pokliu/battery_frame/README.md

# 32140 16S2P 电动自行车电池支架（PETG 3D 打印）

为 32 只小鲁 32140 电芯（16S2P）设计的电池支架（v3）。它装进外框 275（高）×220×165、板厚 0.85 的手工焊接不锈钢箱（内腔约 273.3×218.3×163.3），桶内贴青稞纸。只有底部垫 3 mm 硅胶条；两侧只贴青稞纸，轴向留 5 mm 装配余量（卖家要求，含纸）；顶部不放硅胶，压框顶面到箱盖留 15（让开箱盖紧固螺丝），每条边正中间一个凸台顶住箱盖；前后每边留 1.5。配套 BMS 是 JK-BD6AxxS-8PD。模型由参数化的 FreeCAD 脚本生成，改参数后重跑即可。

## 目录

| 路径 | 内容 |
|---|---|
| `battery_holder_v3.py` | 参数化建模脚本，参数表 `P` 在文件顶部 |
| `电池支架_v3.FCStd` | 生成的模型（打印零件、参考假体、试打块） |
| `STL/`、`STEP/` | 打印文件（按打印方向摆好）和装配坐标 STEP |
| `电池支架v3-需求与进展.md` | 详细参数、连接表、出线、校验、装配顺序、外购件、待实测 |
| `plan_v3.md` | 设计计划 |
| `打印参数_A1_PETG.md` | 各打印件的 Bambu Studio 切片参数 |
| `fem_v3.py`、`fem_run_v3.py` | 受力分析脚本（FreeCAD FEM + CalculiX） |
| `FEA/受力分析报告_v3.md`、`FEA/v3_results.json` | 受力分析结果 |
| `AGENTS.md` | AI 助手设计/修改模型的流程和规则 |
| `JK-BD6A24S06PD.pdf` | BMS 规格书 |

## 设计概要

- **排布**：35 mm 节距正方形网格，下面 5 层每层 6 只，顶层 2 只靠右，顶层空出的位置放 BMS。
- **结构**：两端各一片 24 深的电芯座（挡边 1.5，Ø24 点焊孔），中间 95.5 mm 敞开散热。端盖 A 6.1 厚、B 8.7 厚，底板整面，隔着青稞纸顶住箱壁；支撑垫放在电芯之间的星形位上。6 颗 M4×150 内六角螺丝贯穿端盖 A、两片座（Ø14 定位管定距）和端盖 B，螺丝头没入端盖 A 沉孔，另一端拧进端盖 B 的 M4×8×6 热熔螺母。
- **连接片**：0.1 铜 + 0.1 镍，宽 20。6 处用 4 只一排的直条，9 处用 2×2 整块方片。B−、B+ 都在 B 端最上面一层。
- **出线**：端子片从正中间向上延伸成引出片，伸出支架顶面 22 mm，12AWG 在顶面以上锡焊，从压框顶部开口引到箱盖。
- **缓冲**：只有底部两条 3 mm 硅胶条。
- **温度探头**：贴在中心电芯中段，线从 A 座的 Ø6 孔出来。

## 零件与打印

| 零件 | 数量 | 打印尺寸 (mm) | 打印方向 |
|---|---|---|---|
| 电芯座A | 1 | 214.7×218×73.8 | 挡边朝下，无支撑 |
| 电芯座B | 1 | 214.7×218×71.8 | 挡边朝下，无支撑 |
| 端盖A（螺丝头沉孔） | 1 | 214.7×218×6.1 | 底板朝下 |
| 端盖B（热熔螺母） | 1 | 214.7×218×8.7 | 底板朝下，打完从外表面压入 6 颗 M4×8×6 热熔螺母 |
| 顶部压框 | 1 | 214.7×158.3×72 | 顶环朝下 |
| 压框顶凸台 | 4（一个 STL） | 214.7×158.3×17.5（4 件分开摆） | 顶面朝下，销朝上 |
| 试打块 | 1 | 113×90×27 | 挡边面朝下，**先打这个** |

- 实体合计 1147 cm³。
- 切片参数（拓竹 A1 + PETG + Bambu Studio）见 `打印参数_A1_PETG.md`：层高 0.2、首层 0.3，每个零件的墙层数、底壳层数、填充、Brim 分别给出。
- 当前尺寸按青壳纸 0.3、内腔 = 外框 − 2×0.85 推算，实测后改 `liner_t` / `box_inner` 重跑再打印。

## 外购件

| 物料 | 规格 | 数量 |
|---|---|---|
| 电芯 | 小鲁 32140，Ø33.2±0.2 × 140±0.3 | 32 |
| M4 内六角螺丝 | DIN912 不锈钢 M4×150（头 Ø6.8×4） | 6 |
| M4 热熔螺母 | M4×8×6（长 8、外径 6），端盖 B | 6 |
| M4 普通螺母 + 垫片 | 点焊时临时夹紧用 | 各 6 |
| M3 热熔螺母 + 螺丝 | 孔 Ø4.0 × 6 | 各 4 |
| 硅胶条 | 3×40 长约 215（只放底部） | 2 |
| 铜片、镍条 | 0.1 厚，宽 20；方片约 55×55；引出片 20 宽 | 按需 |
| 12AWG 硅胶线 | 外径 4.5 | 按需 |
| BMS | JK-BD6AxxS-8PD | 1 |
| 青壳纸、青稞纸、Kapton、中性硅胶 | — | 按需 |

## 重新生成模型

在 FreeCAD 1.1 的 Python 控制台执行：

```python
exec(open('/Users/admin/Downloads/battery/battery_holder_v3.py', encoding='utf-8').read())
R = build_all()   # 重建文档「电池支架_v3」，返回校验报告
export_all()      # 导出 STL/、STEP/ 并保存 电池支架_v3.FCStd
```

常改的参数：

| 参数 | 默认值 | 说明 |
|---|---|---|
| `hole_d` | 33.6 | 电芯孔径，按试打块结果改 |
| `lip_t` | 1.5 | 挡边厚（FEA 定） |
| `liner_t` | 0.3 | 青壳纸厚，量到实际值后改 |
| `box_outer` / `sheet_t` / `box_inner` | 220×275×165 / 0.85 / None | 箱外框、板厚；有实测内腔时填 `box_inner` |
| `gap_x` | 1.5 | 前后每边空隙（影响外壁厚） |
| `z_clear_total` | 5.0 | 轴向装配余量合计（含两侧青稞纸） |
| `end_rubber_t` / `top_rubber_t` / `fit_clear` | 0 / 0 / 15 | 两侧、顶部硅胶垫厚（0 = 不放）；压框顶面到箱盖空隙 |
| `insert_hole_d` | 5.6 | 端盖 B 热熔螺母孔，按试打块改 |
| `main_wire_x` / `bplus_x` | None | 引出片 X，None = 端子片正中间 |
| `strip_w` | 20 | 连接片宽 |
| `series` | 16 组 | 串联顺序，两个端子都在最上面一层 |
| `rods` / `bolt_len` | 6 个星形位 / 150 | 螺栓位置、螺丝杆长（沉孔深度自动算） |

受力分析（无界面，较慢）：`freecadcmd fem_run_v3.py`，结果写入 `FEA/v3_results.json`。

## 当前状态

- [x] 建模、自动校验、导出 STL/STEP
- [x] 受力分析（侧摔 50 g、前后/竖直 5 g、50 °C）
- [ ] 实测钢箱内腔和青壳纸厚度，更新参数后重跑
- [ ] 打印试打块；先打一块端盖进箱试配
- [ ] 量铜镍片宽度；确认箱盖插座位置、BMS 端子位置
