pokliu/battery_frame/打印参数_A1_PETG.md

# 打印参数（拓竹 A1 + PETG + Bambu Studio）

适用：0.4 喷嘴，PETG（拓竹 PETG HF / PETG Basic 或同类），纹理 PEI 板。STL 已按打印方向摆好（`STL/` 里每个文件落在 Z=0），导入后直接居中，不要旋转。
基础预设选「0.20mm Standard @BBL A1」+ 对应的 PETG 耗材预设，再按下面改。界面名称以 Bambu Studio 中文界面为准。

## 1. 通用设置（所有零件）

| 位置 | 参数 | 值 | 原因 |
|---|---|---|---|
| 打印板 | 板型 | 纹理 PEI 板 | PETG 在光面 PEI 上粘得太牢，会撕掉板面；用光面板必须涂胶 |
| 耗材 | 喷嘴温度 | 首层 250，其余 245 | 拓竹标的 PETG HF 范围是 230~260 ℃（[拓竹 PETG HF 页面](https://bambulab.com/en-eu/filament/petg-hf)）；偏高一点层间结合更好 |
| 耗材 | 热床温度（纹理 PEI） | 70 | 拓竹 TDS 范围 65~75 ℃（[PETG HF TDS](https://filaments.lv/wp-content/uploads/2026/05/Bambulab-PETG-HF-Filament-TDS.pdf)） |
| 耗材 | 冷却风扇 | 用耗材预设默认（PETG 一般 ≤ 60%） | 风太大层间结合变差 |
| 质量 | 层高 | **0.20** | |
| 质量 | 首层层高 | **0.30** | 见下面"层高说明"：首层 0.3 + 0.2×n 正好卡住挡边 1.5、底板 2.5、端盖 6.1 / 8.7、凸台 14.5 |
| 质量 | 线宽 | 默认 0.42 | |
| 质量 | 墙生成器 | Arachne（默认） | 电芯孔间壁只有 1.4，Arachne 能用变线宽填满 |
| 质量 | X-Y 孔洞补偿 / X-Y 轮廓补偿 | **0 / 0** | 孔径以试打块实测为准，**改脚本参数**（`hole_d`、`insert_hole_d` 等），不在切片里补偿，否则模型和实物对不上 |
| 质量 | 象脚补偿 | 默认 0.15 | |
| 强度 | 稀疏填充图案 | 螺旋体（gyroid） | 各方向强度接近 |
| 支撑 | 开启支撑 | **关** | 所有零件都按免支撑设计（悬垂 ≤45°、菱形窗、水滴孔） |
| 其他 | 打印顺序 | 逐层 | 每盘只放一个大件 |

打印前把 PETG 烘干（65 ℃ 约 6~8 小时）。受潮的 PETG 拉丝多、表面起泡，层间结合也会变差。

### 层高说明
Bambu Studio 按层切片，零件上不是层高整数倍的台阶会被就近取整，误差最多半层。本项目的关键高度是：

| 高度 | 首层 0.2 + 0.2×n | 首层 0.3 + 0.2×n |
|---|---|---|
| 挡边 1.5 | 1.4 或 1.6 ✗ | 0.3 + 6×0.2 = 1.5 ✓ |
| 端盖底板 2.5 | ✗ | 0.3 + 11×0.2 = 2.5 ✓ |
| 端盖 A 6.1 / 端盖 B 8.7 | ✗ | ✓ / ✓ |
| 凸台 14.5 | ✗ | ✓ |

所以统一用首层 0.30。0.4 喷嘴的首层 0.3 在允许范围内，大平面也更容易粘牢。

## 2. 各零件参数

| 零件（STL） | 数量 | 摆放 | 墙层数 | 顶 / 底壳层数 | 填充 | 外墙速度 | Brim | 实体体积（上限） |
|---|---|---|---|---|---|---|---|---|
| 试打块 | 1 | 挡边面朝下（STL 已摆好） | 4 | 5 / 8 | 30% | 100 | 无 | — |
| 电芯座A | 1 | 挡边朝下，定位管朝上 | 4 | 5 / **8** | 30% | **100** | 无 | 370 cm³（≤470 g） |
| 电芯座B | 1 | 同上 | 4 | 5 / **8** | 30% | **100** | 无 | 368 cm³（≤468 g） |
| 端盖A | 1 | 底板朝下 | 4 | 5 / **12** | 40% | 150 | 无 | 123 cm³（≤156 g） |
| 端盖B | 1 | 底板朝下 | **5** | 5 / **12** | 40% | 150 | 无 | 137 cm³（≤174 g） |
| 顶部压框 | 1 | 顶环朝下 | 4 | 5 / **20** | 30% | **100** | **外侧 5 mm** | 133 cm³（≤169 g） |
| 压框顶凸台x4 | 1 盘 4 件 | 顶面朝下，销朝上 | 4 | 5 / 5 | 50% | 100 | 无 | 15 cm³ |

体积是 `checks()` 算的实心体积，克数按 PETG 1.27 g/cm³ 算，是上限，实际用量看 Bambu Studio 切片结果。整套上限约 1.45 kg，加上试打块和试错，准备 2 kg。

### 电芯座 A / B
- **底壳 8 层**：首层 0.3 + 7×0.2 = 1.7 ≥ 挡边 1.5，挡边整片是实心的。挡边是侧摔时直接挡电芯的面，不能有填充。
- **墙 4 层**：孔间壁 1.4、外壁 3.05 这些地方基本全是墙，30% 填充只落在星形位和角上。
- **外墙速度 100**：电芯孔的圆度直接影响装配。A1 是床动机型，零件约 0.45 kg 跟着热床前后移动；上部 6 根 Ø14 定位管单独伸出约 48 mm，慢一点更稳。
- 上部只剩 6 根定位管时每层很小，保持耗材预设里的"层时间不足时降速"（默认开），不然 PETG 会软塌。
- 管顶的凸止口（A）、凹止口（B）配合间隙只有单边 0.2，打完先试插再装电芯。

### 端盖 A / B
- **底壳 12 层**：0.3 + 11×0.2 = 2.5，正好是底板厚，整块底板实心。它是连接片和钢箱壁之间唯一的塑料层，也是侧摔时的承压面。
- 支撑垫 Ø12/Ø13、外周凸台宽 5，4 层墙已经基本把它们填满。
- **端盖 B 墙 5 层**：热熔螺母孔 Ø5.6 周围要实心塑料，5 层墙（约 2.1 mm）加上 Ø13 垫，孔周基本全是墙。
- 端盖只有 6~9 mm 高、面积大，外墙 150 就行。
- 外周凸台侧面的菱形通风窗（A 高 2.4、B 高 5）是 45° 自支撑的，不加支撑。A 的窗很小，上下尖角会被线宽填掉一点，属于正常。
- **热熔螺母（端盖 B）**：打完后从端盖 B **外表面**（贴打印板的那面）压入 6 颗 M4×8×6。烙铁 230~245 ℃，垂直慢压，压到比表面低约 0.3 停，趁热用平面压一下保证不歪。

### 顶部压框
- 顶环朝下，墙只有 3 厚、高 72，底面只有一圈 10 宽的顶环贴板，**加 5 mm 外侧 Brim**，防止床动时翘边或被撞倒。
- **底壳 20 层**：0.3 + 19×0.2 = 4.1 ≥ 顶环厚 4，顶环整圈实心。凸台的压力经顶环传到墙上。
- 外墙 100：薄墙高件，床动机型上不要快。
- 侧墙上的菱形窗是 45° 自支撑的，不加支撑。
- 顶环和两条对角支撑条都贴在打印板上，是第一层的一部分。

### 压框顶凸台
- 一盘打 4 个（20 宽的两个放长边，30 宽的两个放短边）。凸台顶面贴板，Ø4 定位销朝上，销是最后几层。
- 小件，填充 50% 即可，只受压。

### 试打块（最先打）
- 和电芯座同样设置，结果才有参考价值。
- 量完后改脚本：`hole_d`（电芯孔）、`lip_t`（挡边）、`socket_d` / `spigot_d`（止口）、`insert_hole_d`（M4 热熔孔，三个孔 Ø5.5/5.6/5.7，有缺口标记的是 5.5）、`m3_d`。改完重跑 `build_all()` → `export_all()` 再打正式件。

## 3. 建议打印顺序
1. 试打块 → 实测，改参数，重新导出。
2. 端盖 A（最薄最快）→ 放进钢箱试配两侧和前后空隙。
3. 电芯座 A、电芯座 B → 试插电芯、对止口。
4. 端盖 B → 压热熔螺母。
5. 顶部压框、凸台 → 放进箱子盖上箱盖试配，核对箱盖螺丝不碰凸台。

## 4. 常见问题
- **拉丝**：先烘干；还拉丝就把喷嘴温度降 5 ℃。
- **首层翘边**：纹理板用洗洁精洗净，不要用手摸板面；热床可以升到 75。
- **孔偏小**：不要在切片里加孔洞补偿，按第 2 节"试打块"改脚本参数。
- **大件取不下来**：等热床降到室温，PETG 在纹理 PEI 上冷却后会自己松开。
