pokliu/battery_frame/电池支架v3-需求与进展.md

# 电池支架 v3 — 需求与进展

工程文件：`电池支架_v3.FCStd`（由 `battery_holder_v3.py` 生成）。计划见 `plan_v3.md`，受力分析见 `FEA/受力分析报告_v3.md`。
更新日期：2026-11-12

> **注意**：当前尺寸按"不锈钢箱外框 220×275×165、板厚 0.85、青壳纸 0.3"推算，内腔 218.3×273.3×163.3。青壳纸厚度和内腔实测值确定后要改参数重跑，再打印。

## 1. 与 v2 相比
| 问题（v2） | v3 的做法 |
|---|---|
| 耗材多、死重大（实体 2370 cm³） | 两片 24 深电芯座 + 两块端盖 + 压框，实体 **1147 cm³**（约 −52%） |
| 全包、散热差 | 中间 95.5 mm 敞开，电芯约 68% 长度露在空气里；座上 14 个 Ø8 通风孔 |
| 侧向撞击顶破打印件 | 端盖整面隔着青稞纸顶箱壁，侧摔 50 g 下挡边 17.5 MPa |
| 连接片过流不一致 | 直条 1 条桥（12 A/mm² @30 A），2×2 方片 2 条桥（6 A/mm²），用户确认可接受 |
| 底部无缓冲 | 底部两条 3 mm 硅胶条；两侧只贴青稞纸，顶部不放 |

## 2. 装配间隙（手工焊接钢箱，不平整）
| 方向 | 从箱壁往里 | 说明 |
|---|---|---|
| 两侧 Z（165，车的左右） | 青稞纸 0.3 + 空隙 2.2 | 卖家要求装配余量 5 mm：内腔 163.3 − 支架 158.3 = 5.0（含两侧青稞纸，每侧 2.5）。不放硅胶垫（用户要求） |
| 顶部 Y | 压框顶面到箱盖 15；4 个凸台顶面到箱盖 0.5 | 箱盖靠螺丝和箱体紧固，螺丝伸进箱内，留 15 不干涉；每条边正中间一个凸台顶住箱盖。不放硅胶条 |
| 底部 Y | 青壳纸 0.3 + 硅胶条 3 | 两端各一条 3×40 |
| 前后 X（220） | 青壳纸 0.3 + 空隙 **1.5** | 6 只电芯 × 35 节距已占 210，留不出 3 mm；空隙 1.5 时外壁最薄 3.05 |

## 3. 文件
| 文件 | 说明 |
|---|---|
| `battery_holder_v3.py` | 参数化建模脚本，参数表 `P` 在文件顶部 |
| `fem_v3.py`、`fem_run_v3.py` | 受力分析（无界面运行：`freecadcmd fem_run_v3.py`） |
| `STL/*.stl` | 已按打印方向摆好、落在 Z=0 |
| `STEP/*.step` | 装配坐标 |
| `打印参数_A1_PETG.md` | 拓竹 A1 + PETG 的 Bambu Studio 切片参数 |

## 4. 零件与打印
| 零件 | 打印尺寸 (mm) | 打印方向 | 实体体积 |
|---|---|---|---|
| 电芯座A（凸止口） | 214.7×218×73.8 | 挡边朝下，定位管朝上，无支撑 | 370 cm³ |
| 电芯座B（凹止口） | 214.7×218×71.8 | 同上 | 368 cm³ |
| 端盖A（螺丝头沉孔） | 214.7×218×6.1 | 底板朝下 | 123 cm³ |
| 端盖B（热熔螺母孔） | 214.7×218×8.7 | 底板朝下；打完从外表面压入 6 颗 M4×8×6 热熔螺母 | 137 cm³ |
| 顶部压框 | 214.7×158.3×72 | 顶环朝下 | 133 cm³ |
| 压框顶凸台 ×4 | 长边 20×10×14.5 两个、短边 30×10×14.5 两个（STL 一次打 4 个） | 顶面朝下，定位销朝上 | 15 cm³ |
| 试打块 | 113×90×27 | 挡边面朝下，**先打** | — |

## 5. 关键参数
| 参数 | 值 |
|---|---|
| 外形 | 宽 214.7，轴向 158.3（两端盖外表面），高 255（底面落在硅胶条上，压框顶面到箱盖 15） |
| 电芯孔 / 节距 | Ø33.6 / 35，孔间壁 1.4；外壁最薄 X 向 3.05、Y 向 4.7；顶层块左壁 4.2 |
| 挡边 | 1.5，Ø24 点焊孔；电芯端面比挡边外表面低约 1.75 |
| 电芯座 | 总深 24，电芯插入 22.5；中间敞开 95.5 |
| 端盖 | A 厚 6.1（底板 2.5 + 支撑垫 3.6），B 厚 8.7（底板 2.5 + 支撑垫 6.2，热熔螺母需要 8.7）；底板整面不开窗；外周凸台宽 5，凸台侧面开菱形通风窗（45° 自支撑，在凸台高度正中，上下各留 0.6 实料）：端盖 A 内空间只有 3.6，窗高 2.4，共 54 个；端盖 B 窗高 5，共 39 个；避开顶边出线槽；普通垫 Ø12，螺栓垫 Ø13 |
| 顶部压框 | 墙厚 3，顶环宽 10、厚 4；顶环内两条 10 宽的**对角支撑条**（X 形，角到角），正中线上只有中心交叉处有料，其余位置可以打孔；总出线区让开支撑条后在顶环开口内还有约 1900 mm² |
| 贯穿螺栓 | 6 颗 M4×150 内六角（不锯），星形 (1,0)(3,0)(0,1)(3,2)(1,3)(4,3)。端盖 A 沉孔 Ø7.4×5.35，沉孔底 0.75 压在挡边上，头顶低于外表面 1.35；端盖 B 每个螺栓位一个 Ø5.6 热熔螺母孔（打穿 8.7，孔壁到垫外沿 3.7），M4×8×6 热熔螺母外端低于外表面 0.3；螺丝拧入热熔螺母 5.35（≥5），杆末端低于端盖 B 外表面 2.95（螺丝长 +1.25 的公差也不会顶到箱壁） |
| 定位管 | Ø14/Ø4.6，A 端凸止口 Ø9×2，B 端凹止口 Ø9.4×2.3；到电芯上限外径间隙 1.05 |
| BMS | 136 沿 Z（5.4~141.4），X 18.4~121.4，底面 Y=190；M3 Ø4×6 水滴孔 Z=11.4 / 135.4；插座端空间 10.0 |
| 探头 | 贴中心电芯 (2,2) 中段；线经星形 (2,2) 的 Ø6 孔到 A 端 |

## 6. 串联与连接片（两个端子都在最上面一层）
```
层5: .. .. .. .. 16 16      ← B+（B 端）
层4:  1  1 14 14 15 15      ← 1 = B−（B 端）
层3:  2  2 13 13 12 12
层2:  3  3  4  4 11 11
层1:  6  6  5  5 10 10
层0:  7  7  8  8  9  9
```
| 端 | 直条（4 只一排） | 2×2 方片（中心星形） |
|---|---|---|
| A | 3→4、5→6、7→8 | 1→2 (0,3)、9→10 (4,0)、11→12 (4,2)、13→14 (2,3)、15→16 (4,4) |
| B | 8→9、12→13、14→15 | 2→3 (0,2)、4→5 (2,1)、6→7 (0,0)、10→11 (4,1)；另有 B−、B+ 端子片 |

- 程序搜索了所有"相邻两组只用直条或 2×2 方片连接、第 1 组和第 16 组都在最上面一层"的排法，只有 4 种（加上反向共 8 种），都需要 9 块方片。这一种可用螺栓位分布最均匀。
- 连接片：0.1 铜 + 0.1 镍，宽 20；方片约 55×55，宽铜片自裁，不挖孔。方片中心的星形位不放支撑垫和螺栓。

## 7. 正负极引出
- **引出片**：B−、B+ 端子片（B 端最上面一层）从端子片**正中间**（两只电芯中心连线的中点，B− X=37.35，B+ X=177.35）向上延伸成 20 宽的引出片，穿过端盖顶边槽（B− 在 X 26.35~48.35，B+ 在 X 166.35~188.35，槽位由脚本按引出片自动加），伸出支架顶面 22 mm。可以用同一条铜片直接折上去，也可以另点焊一段。
- **焊接**：12AWG 在支架顶面以上锡焊到引出片外侧，离电芯 20 mm 以上。压框 B 端后墙在两个引出片处开了缺口，焊点区深 8.15（12AWG 外径 4.5）。
- **B−**：焊好后越过 BMS 顶面接 BMS 的 B− 端子。引出片离 BMS 端面 0.6，BMS 端子实际位置要核对。
- **B+**：焊好后向内弯进出线区。出线区 X 100~204，Z 118~137.6，从顶层块顶面上方一直到箱盖，在压框顶环开口以内。BMS 的 P− 也从这里接到箱盖插座。
- 引出片、焊点区、走线区、出线区与所有零件、BMS、电芯干涉为 0。

## 8. 校验结果（脚本自动）
- 所有零件与电芯、连接片、探头、BMS、引出片、螺栓、青壳纸、硅胶垫/条的干涉体积都为 0；两片座止口对接干涉为 0。
- 间隙：X 每边 1.5（扣纸）；Z 每边 2.2（扣纸），合计余量 5.0（含纸）；顶部 15。
- 引出片中心与端子片中间的偏差 0 / 0。
- 热熔螺母孔内无塑料，孔深 8.7 = 端盖 B 厚，孔壁到垫外沿 3.7（≥3）。
- 支撑垫到连接片 ≥ 1.0，凸台内沿到连接片 4.85，探头孔到连接片 4.5。
- 每组两端各接一次；直条桥数 1，方片桥数 2；螺栓都不在方片中心上，且两端都有支撑垫。
- 螺栓尺寸 OK：沉孔底 0.75（≥0.6），头顶低于端盖 A 外表面 1.35，拧入热熔螺母 5.35，杆末端低于端盖 B 外表面 2.95。
- STL 全部封闭，单件最大 218，256 打印机放得下。

## 9. 受力分析（摘要）

> 下表是"硅胶垫版"（端盖 6.1、两侧/顶部有硅胶）的结果。去掉两侧/顶部硅胶、端盖改为 A 6.1 / B 8.7 后**没有重跑**（用户要求以后不主动做 FEM）。挡边的支撑垫布置没变，挡边应力应基本不变；端盖底板现在隔着青稞纸直接贴钢壁，不再是"压在硅胶上"的工况。
| 工况 | 主拉应力最大 | 判定 |
|---|---|---|
| 侧摔 50 g，挡边 1.5（A 端 / B 端支撑垫布置） | 17.5 / 17.2 MPa | ≤ 30 ✓ |
| 端盖底板压在硅胶垫上（手算，弹性地基板） | 约 12 MPa | ≤ 30 ✓ |
| 前后 5 g（外壁 3.05） | 0.52 MPa | ✓ |
| 竖直向下 / 向上 5 g | 0.48 / 3.0 MPa | ✓ |
| 压框向上 5 g（后墙开缺口） | 1.33 MPa | ✓ |
| 螺栓（手算） | 冲击时每颗约 45 N | ✓ |

## 8.1 压框顶凸台
- 箱盖与箱体每个侧面的接缝处各有 2 颗螺丝伸进箱内。位置是用户回忆的：长边距两端约 60 或 90，短边约 40，还没测量。
- 每条边正中间放一个凸台（以箱内腔中线为准），高 14.5，顶面到箱盖 0.5。长边凸台宽 20：按螺丝距端 90 的最坏情况，两颗螺丝之间只剩约 38。短边凸台宽 30。
- 校验时按两种回忆位置都画了螺丝假体（半径按 5 算，含螺母），凸台与螺丝干涉为 0，最近距离 4.15。
- 凸台底面有 2 个 Ø4×3 的销，插进压框顶环的 Ø4.4 孔（顶环厚 4）。凸台只受压，不用螺丝，可以点胶固定。
- 整包向上 5 g 时 4 个凸台总承压面积 1000 mm²，压应力约 0.54 MPa。
- 装箱前确认螺丝位置；如果和凸台冲突，改 `boss_w_long`、`boss_w_short` 或 `lid_screws_*` 后重跑。

## 9.1 螺栓数量与连接片（手算，2026-11-12）
问题：6 颗 M4 是否足以让电芯座在颠簸时不被电芯顶变形，避免连接片反复受力、焊点疲劳脱开。
- 两侧各有 2.2 的空隙，日常行驶时端盖不贴箱壁。电芯的轴向惯性力走的路径是：挡边 → 支撑垫 → 端盖 → 6 颗螺栓 → 另一片座。这时决定变形的是电芯座 24 深的孔格板在螺栓之间的弯曲。
- 侧向 2 g：32 只 × 0.3 kg × 2 g = 188 N，均布约 0.004 MPa。按点支撑板估算，螺栓间距取 100（偏大），PETG 50 °C 下 E≈1700 MPa，孔格板有效刚度只取实心 24 板的 10%（偏保守），相邻电芯端面的相对位移约 0.01 mm。即使刚度只有实心板的 1%，也只有约 0.1 mm。
- 对比：每只电芯在 140.5 腔里本身有约 0.5 mm 轴向窜动，比座变形大 50 倍。焊点疲劳的主要来源是这个窜动，不是螺栓数量。
- 结论：**6 颗够用，不增加**。加到 10 颗，最大跨度从约 100 降到约 70，变形大约从 0.01 降到 0.003，对连接片没有实际意义，还要少 4 个减重孔。多买的 4 颗留作备件。
- 要做的是消除电芯窜动：每只电芯在 A 座孔里点 2~3 点中性硅胶（第 10 节第 2 步），或在 B 端电芯端面和挡边之间垫 0.5 青稞纸垫圈后再点焊。
- 两侧 2.2 的空隙让整包在箱里能左右移动约 4.4，侧向冲击时整包会撞箱壁。这对连接片是整体平移，不产生相对变形，但会有敲击声。要消除的话，装箱后在端盖外侧塞薄 EVA 或硅胶片填空隙（装配时空间仍在）。

## 10. 装配顺序
1. 压入 4 个 M3 热熔螺母（两片座的导轨）和 6 个 M4×8×6 热熔螺母（端盖 B，从外表面压入，外端低于表面约 0.3）。
2. A 座挡边朝下放平，按第 6 节极性插入 32 只电芯。建议每只电芯在 A 座孔里点 2~3 点中性硅胶，消除 0.5 mm 轴向间隙。
3. 扣上 B 座（止口对准定位管）。点焊前先用 6 颗 M4×150 直接夹在两片挡边外侧：头下垫一个垫片，另一端用普通 M4 螺母临时拧紧。
4. 点焊：先放铜片（直条、方片），再叠镍条；B−、B+ 端子片带向上的引出片。焊采样线，贴青稞纸。
5. 拆下螺栓，装上两块端盖：螺栓从端盖 A 穿入，拧进端盖 B 的热熔螺母，拧到贴紧后再转约 1/4 圈（≤ 0.2 N·m）。热熔螺母没有防松，建议头下加弹簧垫圈，或在杆末端几牙点中强度螺纹胶（别流到塑料上）。
6. 在支架顶面以上把 12AWG 锡焊到两片引出片上。装 BMS，接 B− 和采样线。
7. 钢桶内贴青稞纸（四周、两端面、底面），底部两端各放一条硅胶条，装入支架，放上压框，把 4 个凸台的销插进压框顶环的孔（长边放 20 宽的，短边放 30 宽的），B+ 和 P− 从压框顶部开口引到箱盖，盖上箱盖。两侧和顶部不放硅胶。

## 11. 外购件
| 物料 | 规格 | 数量 |
|---|---|---|
| M4 内六角螺丝 | DIN912 不锈钢 M4×150（头 Ø6.8×4） | 6 |
| M4 热熔螺母 | M4×8×6（长 8、外径 6），端盖 B | 6 |
| M4 普通螺母 + 垫片 | 点焊时临时夹紧用 | 各 6 |
| M3 热熔螺母 + 螺丝 | Ø4.0×6 | 各 4 |
| 硅胶条 | 3×40 长约 215（只放底部） | 2 |
| 铜片 / 镍条 | 0.1 厚；直条 20 宽，方片约 55×55，引出片 20 宽 | 按需 |
| 12AWG 硅胶线 | 外径 4.5 | B−、B+、P− |
| 青壳纸、青稞纸、Kapton、中性硅胶 | — | 按需 |

## 12. 与计划的偏差
- **换层连接片**：计划是 U 形，用户改为 2×2 整块方片。
- **串联顺序**：原来按层蛇形，B− 在左下。用户要求两个端子都在最上面一层，改成第 6 节的排法，方片从 5 块变成 9 块。
- **引出方式**：原来 12AWG 在端盖里面走到顶边。现在端子片直接向上延伸出顶边，在支架顶面以上锡焊，端盖里不走粗线。
- **螺栓**：牙条 → M4 内六角长螺丝贯穿（头在 A、尼龙螺母在 B）。用户没法锯螺丝，改用 M4×150，头和螺母都没入端盖深沉孔，沉孔底 0.75。
- **箱体尺寸**：220×275×165 是外框，板厚 0.85。手工焊接不平整，两侧和顶部改为 3 mm 硅胶垫 + 0.5 空隙，前后留 1.5（节距限制）。端盖 9.75 → 6.1，取消边框通风窗。
- **挡边 2.5 → 1.5**：FEA 显示 1.5 满足要求，焊接更方便。
- **去掉两侧、顶部硅胶**（2026-11-12）：用户要求只有底部放硅胶条，两侧只贴青稞纸。
- **端盖边框通风窗恢复**：端盖 9.75 → 6.1 时因为内部只剩 3.6 高（当时外面还贴硅胶垫）取消了，后来端盖 B 改到 8.7 时没有恢复，这是遗漏。现在 A、B 都开：A 窗高 2.4（内空间只有 3.6，再大就碰到底板或挡边），B 窗高 5。
- **压框顶环支撑条改成对角两条**（用户要求）：原来是沿 X 方向正中一条，用户要在正中线上打孔。总出线区（B+、P− 到箱盖）让开对角条，线从条旁边的开口上去。
- **顶部留 15**：箱盖紧固螺丝伸进箱内，压框顶面到箱盖留 15（原 0.5），压框高 86.5 → 72。压框向上 5 g 的 FEA 是旧高度的结果，没有重跑；压框变矮，墙更短，应力不会变大。压框顶面每条边正中间加了一个单独打印的凸台顶住箱盖，避开箱盖紧固螺丝（见 8.1 节）。
- **Z 向装配余量 5 mm**（卖家要求）：支架轴向 161.7 → 158.3，内腔 163.3 − 158.3 = 5.0（含两侧青稞纸）。按"合计 5 mm"理解；若是每侧 5 mm，两块端盖合计只剩 9.2，装不下 8 长的热熔螺母，不可行。
- **引出片移到端子片正中间**：原来 B− 在 X 51、B+ 在 X 161（偏向一只电芯），现在都在两只电芯中心连线的中点，端盖槽和压框缺口跟着移动。
- **端盖 B 改用 M4×8×6 热熔螺母**（用户要求，取代尼龙螺母）：端盖 B 厚度由热熔螺母决定（8 + 0.3 + 0.4 = 8.7），端盖 A 用剩下的 6.1，两块端盖不再对称，B 端零件不再整体镜像，而是按各自厚度建模后镜像。

## 13. 待实测 / 待确认
- [ ] **箱盖紧固螺丝位置**：量长边、短边上螺丝离两端的距离，核对凸台不冲突（见 8.1 节）。
- [ ] **X 是否也要 5 mm 装配余量**：现在 X 合计 3.6（含纸），待用户确认。
- [ ] **前后 X 间隙**：用户希望 3~5 mm，受 6×35 节距限制最多约 1.5（外壁 3.05）。是否接受，或者在前后再塞 1 mm 硅胶片，待用户确认。
- [ ] **钢箱内腔实测**：宽、深、高各量 3 处，以及内角圆角、焊缝鼓包。填 `box_inner` 后重跑。
- [ ] **青壳纸厚度**，改 `liner_t` 后重跑。
- [ ] 打印试打块：上排孔 Ø33.4/33.6/33.8（切角那侧是 33.4），下排是挡边 1.5/2.0/2.5 样段；另有螺丝过孔、凹止口、带凸止口的定位管段、M3 试孔；-Y 侧试孔条是 M4×8×6 热熔螺母孔 Ø5.5/5.6/5.7（有缺口标记的是 5.5），选压入后不松、不鼓包的那个改 `insert_hole_d`。
- [ ] 先打一块端盖 A（6.1 mm 厚，打得快）放进钢箱试配。
- [ ] 铜片、镍条实物宽度，改 `strip_w` 后重跑校验（支撑垫余量目前 1.0）。
- [ ] 箱盖上插座的位置和尺寸；BMS 端子（B−、P−）的实际位置。
