pokliu/battery_frame/FEA/受力分析报告_v3.md

# 电池支架 v3 受力分析报告

工具：FreeCAD 1.1.4 FEM，Gmsh 二阶四面体（压框用一阶），CalculiX 线性静力。脚本：`fem_v3.py`（工况）、`fem_run_v3.py`（无界面批量）。原始结果：`FEA/v3_results.json`。

## 1. 载荷与材料

| 项 | 取值 | 说明 |
|---|---|---|
| 电芯 | 0.300 kg × 32 = 9.6 kg | |
| 侧向（Z，电芯轴向，朝车的左右） | **50 g** 一次性冲击 | 1 m 摔车，坐桶、车架、外壳先缓冲一部分。参考 UN38.3 大电池冲击（50 g / 11 ms） |
| 前后（X）、竖直（Y） | **5 g** | 40 km/h 城市路面 |
| 日常振动 | 2 g | 结果按 5 g × 0.4 换算 |
| PETG 50 °C | E = 1700 MPa，ν = 0.38 | 估算值 |
| 许用 | 50 g：主拉 ≤ 30 MPa（允许轻微永久变形、不破裂）；5 g：≤ 18 MPa；2 g：≤ 8 MPa | 层内强度 50 °C 约 30–35 MPa |

电芯座模型不含定位管和 BMS 导轨，刚度偏低，结果偏保守。

## 2. 侧摔 50 g：电芯冲向挡边（决定挡边厚度）

32 只电芯各 147 N，加在挡边内表面的接触环上（Ø24~Ø33.2），合力 4709 N。挡边外表面与端盖支撑垫、外周凸台接触的面固定（端盖经 3 mm 硅胶垫整面顶在箱壁上，端盖本身按刚性处理，底板受弯另行手算）。

| 方案 | 主拉应力最大 (MPa) | von Mises 最大 (MPa) | 最大变形 (mm) | 结论 |
|---|---|---|---|---|
| 挡边 2.5（初版 20 个支撑垫） | 6.6 | 5.0 | 0.06 | ✓ |
| 挡边 2.0（初版） | 10.7 | 6.9 | 0.07 | ✓ |
| 挡边 1.5（初版） | 16.3 | 10.5 | 0.10 | ✓ |
| 挡边 1.2（初版） | 24.6 | 14.6 | 0.14 | △ 余量小，且只有 3 条线宽 |
| **挡边 1.5，方片版，A 端支撑垫（17 个）** | **16.4** | 10.3 | 0.11 | ✓ 采用 |
| **挡边 1.5，方片版，B 端支撑垫（19 个）** | **16.4** | 10.7 | 0.11 | ✓ 采用 |
| 挡边 2.0，方片版，A / B | 10.6 / 9.8 | 7.1 / 7.2 | 0.08 | ✓ |

| 挡边 1.5，顶部端子版，A / B 端支撑垫 | 17.2 / 16.8 | 10.7 | 0.14 | ✓ |
| **挡边 1.5，硅胶垫版，A 端支撑垫（15 个）** | **17.5** | 10.5 | 0.14 | ✓ **当前采用** |
| **挡边 1.5，硅胶垫版，B 端支撑垫（17 个）** | **17.2** | 11.0 | 0.11 | ✓ **当前采用** |

"顶部端子版"：串联顺序改成 B−、B+ 都在最上面一层，方片增加到 9 块（A 端 5 块、B 端 4 块），箱体按外框 − 2×0.85 板厚重新计算。
"硅胶垫版"：两侧、顶部改为 3 mm 硅胶垫 + 0.5 空隙，前后每边 1.5，支架宽 214.7（X 向外壁最薄 3.05），端盖厚 6.1。

"方片版"：换层改成 2×2 整块方片后，方片中心的星形位不能放支撑垫（A 端少 (4,0)(4,2)(4,4)，B 端少 (0,1)(0,3)），A 端还少一个探头位 (2,2)。少了这几个垫，最大应力几乎不变，因为挡边主要靠孔壁和外周凸台撑住。

- **采用挡边 1.5**：当前版本 50 g 下主拉应力 17.5 MPa，安全系数约 1.7–2。电芯端面比挡边外表面只低约 1.75 mm（v2 是 2.75），点焊时连接片压下去的深度更浅。
- 支撑面平均压应力 0.83 MPa（4709 N / 约 5650 mm²），局部最大主压应力约 10 MPa，PETG 受压没有问题。
- **端盖底板压在硅胶垫上（手算）**：底板 2.5 厚，下面是 3 mm 硅胶（50A，E≈2 MPa，地基系数 k≈0.67 N/mm³），按弹性地基板估算，特征长度 l=(D/k)^¼≈7.9 mm。
  - 支撑垫约承担 35% 的冲击力，每个垫约 97 N，底板弯曲应力约 12 MPa。
  - 外周凸台承担约 65%，线载荷约 3.5 N/mm，底板边缘约 8.5 MPa。
  - 硅胶最大压应力约 0.2 MPa，整包压进硅胶约 0.15 mm。
  - 都低于 30 MPa。硅胶是一次性冲击下的缓冲，日常只受自重。
- 侧向 2 g 日常振动约 0.7 MPa。

## 3. 前后 5 g（X）

每只电芯的力由两片座平分（7.4 N/只/片），加在孔壁朝 +X 的半圆上，座的 +X 外侧面（经青壳纸顶箱壁）固定。

| 主拉最大 | von Mises 最大 | 最大变形 |
|---|---|---|
| 0.52 MPa | 1.15 MPa | 0.12 mm |

（以下第 3~5 节均为当前版本：硅胶垫版、宽 214.7、X 向外壁最薄 3.05。外壁从 4.05 减到 3.05 后，前后 5 g 应力基本不变。）

## 4. 竖直 5 g（Y）

| 工况 | 支撑 | 主拉最大 | von Mises 最大 | 最大变形 |
|---|---|---|---|---|
| 向下（落向箱底） | 底面（胶条） | 0.48 MPa | 1.16 MPa | 0.12 mm |
| 向上（回弹顶压框） | 只算压框左墙、右墙各 3 mm 宽的接触带 | 2.99 MPa | 6.42 MPa | 0.30 mm |

向上工况只用了两条 3 mm 宽的接触带，实际端盖顶边、螺栓也会分担，结果偏保守。

## 5. 压框：整包向上 5 g

受压质量约 10.6 kg（电芯 + 支架 + BMS），合力 522 N。B 端后墙在两个引出片处开了缺口。

| 主拉最大 | von Mises 最大 | 最大变形 |
|---|---|---|
| 1.33 MPa | 1.89 MPa | 0.08 mm |

最大应力在后墙缺口边上，仍然很低。实际上压框顶环和箱盖之间还有 3 mm 硅胶条，力会更分散。

## 6. 贯穿螺栓（手算）

- **螺栓长度**：用 M4×150，不锯。两挡边外表面间距 143.5，加尼龙螺母高 5 是 148.5，剩下的 1.5 分给两端沉孔底，每边 0.75。头、螺母都没入端盖（低于外表面 1.35 / 0.35）。沉孔底 0.75 背面直接贴在挡边上，只受压，200 N 预紧下约 9 MPa（头）/ 8 MPa（螺母），可以接受。
- **冲击时螺栓基本不受力**：侧摔时电芯压的是靠撞击侧的挡边，力经端盖直接到箱壁。前后、上下方向的力由电芯座直接传到箱壁、胶条、压框。螺栓只拉住远离撞击侧的那片座、那块端盖和半个 BMS 的惯性，约 0.55 kg × 50 g = 268 N，6 颗平均每颗约 45 N。M4 A2-70 的屈服载荷约 4.4 kN。
- **螺栓的作用**：把两片座、两块端盖夹成一体，靠定位管定距、止口定位；装箱前搬运时整包的重量也挂在螺栓上。
- **预紧力要小**：M4 头部压在 PETG 上的环面只有约 22 mm²。按 0.3 N·m 拧紧，预紧力约 375 N，压应力约 17 MPa，50 °C 下会慢慢蠕变松弛。建议拧到贴紧后再转约 1/4 圈（约 0.15–0.2 N·m，预紧力约 200 N，头下约 9 MPa，定位管 1.5 MPa），靠尼龙防松螺母防松，不靠预紧力。
- **定位管**：Ø14/Ø4.6，截面 137 mm²，两段对接后长 95.5。按两端铰支估算，欧拉临界载荷约 3.3 kN，远大于预紧力。
- **数量和位置**：螺栓位要避开方片中心和探头星形位。用"截面上任一点到最近螺栓的均方根距离"评估：上一版（5 块方片，15 个可选位）4 颗 44.6 mm，5 颗 41.4，6 颗 38.3，7 颗 36.6，8 颗 35.0，6 颗以后改善很小。当前版（9 块方片）只剩 11 个可选位，6 颗最优组合是 (1,0)(3,0)(0,1)(3,2)(1,3)(4,3)，40.3 mm。顶层块没有可用的星形位（(4,4) 被 15→16 方片盖住），那里靠电芯座本身的整体刚度和端盖外周凸台。

## 7. 50 °C 热影响

- 模量按 1700 MPa 计算，以上结果已包含。
- 热膨胀（ΔT 30 °C，α ≈ 68×10⁻⁶/K，钢箱按不膨胀算）：宽 214.7 胀 0.44 mm（前后空隙合计 3.0）；轴向 155.7 胀 0.32 mm、高 266.5 胀 0.54 mm，都由硅胶垫/条压缩吸收，不会顶死。
- 中间 95.5 mm 敞开，电芯约 68% 的长度直接暴露在空气中，比 v2 散热好。

## 8. 局限

- 冲击加速度是假设值，线性静力，没有考虑动态放大、接触非线性和打印缺陷。
- 电芯座模型不含定位管和导轨；向上工况只用两条压框接触带。
- 电芯在 140.5 腔内有约 0.5 mm 轴向间隙，长期振动时会轻微敲击挡边并拉扯焊点（v2 也一样）。建议每只电芯在一端座孔里点 2~3 点中性硅胶固定。
