pokliu/battery_frame/STEP/电芯座B.step

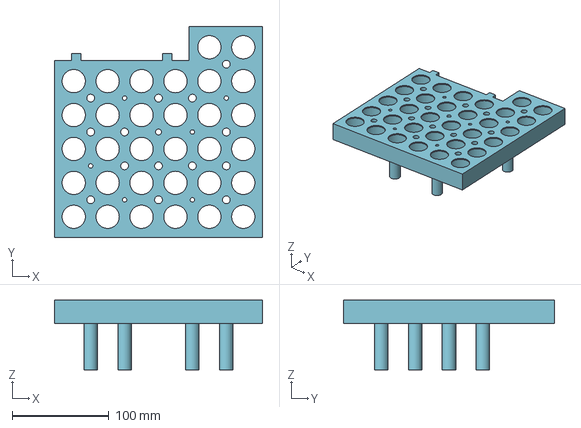
[picture p1: CAD file, 2026-11-13]
STEP/电芯座B.step
214.7 x 218.0 x 71.8 mm
