pokliu/battery_frame/电池支架_v3.FCStd

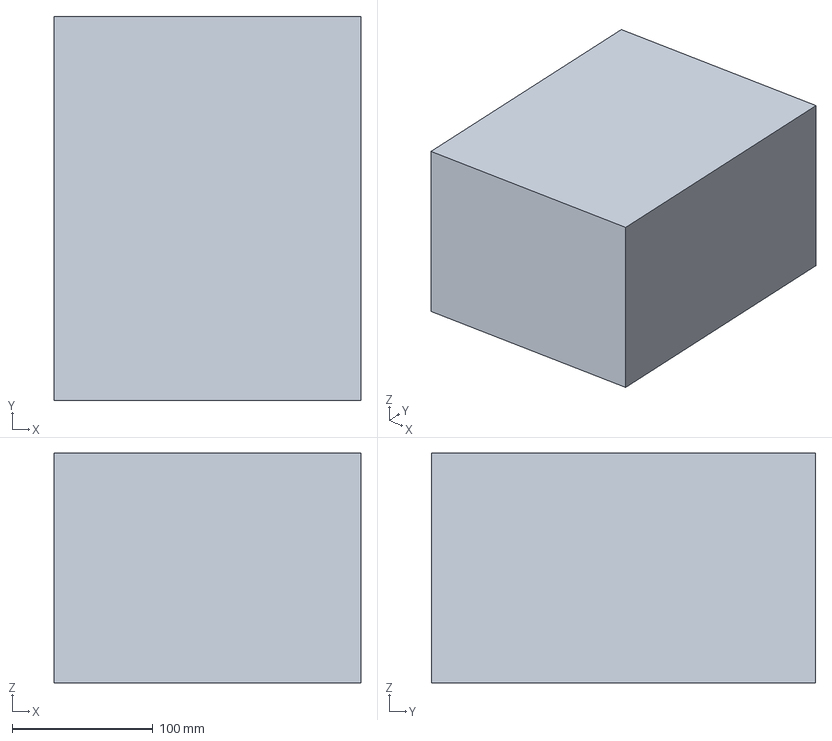
[picture p2: CAD file, 2026-11-13]
电池支架_v3.FCStd
218.3 x 273.3 x 163.3 mm
箱盖紧固螺丝假体(两种回忆位置)
电芯_第7组_(1,1)
电芯_第7组_(2,1)
电芯_第8组_(3,1)
电芯_第8组_(4,1)
电芯_第9组_(5,1)
电芯_第9组_(6,1)
电芯_第6组_(1,2)
电芯_第6组_(2,2)
电芯_第5组_(3,2)
电芯_第5组_(4,2)
电芯_第10组_(5,2)
电芯_第10组_(6,2)
电芯_第3组_(1,3)
电芯_第3组_(2,3)
电芯_第4组_(3,3)
电芯_第4组_(4,3)
电芯_第11组_(5,3)
电芯_第11组_(6,3)
电芯_第2组_(1,4)
电芯_第2组_(2,4)
电芯_第13组_(3,4)
电芯_第13组_(4,4)
电芯_第12组_(5,4)
电芯_第12组_(6,4)
电芯_第1组_(1,5)
电芯_第1组_(2,5)
电芯_第14组_(3,5)
电芯_第14组_(4,5)
电芯_第15组_(5,5)
电芯_第15组_(6,5)
电芯_第16组_(5,6)
电芯_第16组_(6,6)
连接片_A端_straight
连接片_A端_square
连接片_B端_straight
连接片_B端_square
连接片_B端_terminal
NTC探头假体
BMS假体_JK-BD6A
B−引出片(顶层,向上)
B+引出片(顶层,向上)
12AWG焊点与走线区
总正负出线区_到箱盖
M4x150贯穿螺栓
M4x8x6热熔螺母(端盖B)
青壳纸
底部硅胶条3x40
箱体内腔_275x220x165
电芯座A
电芯座B
端盖A
端盖B
顶部压框
压框顶凸台x4
