pokliu/battery_frame/STEP/端盖A.step

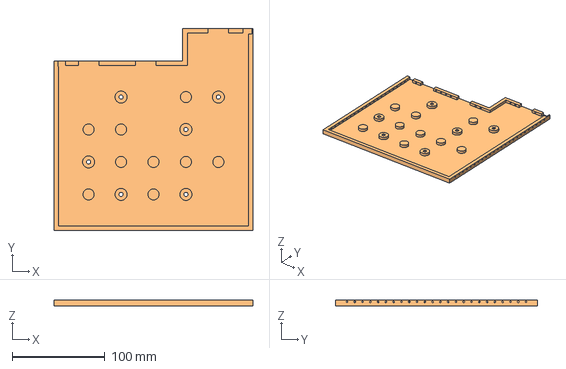
[picture p3: CAD file, 2026-11-13]
STEP/端盖A.step
214.7 x 218.0 x 6.10 mm
