pokliu/battery_frame/STEP/压框顶凸台x4.step

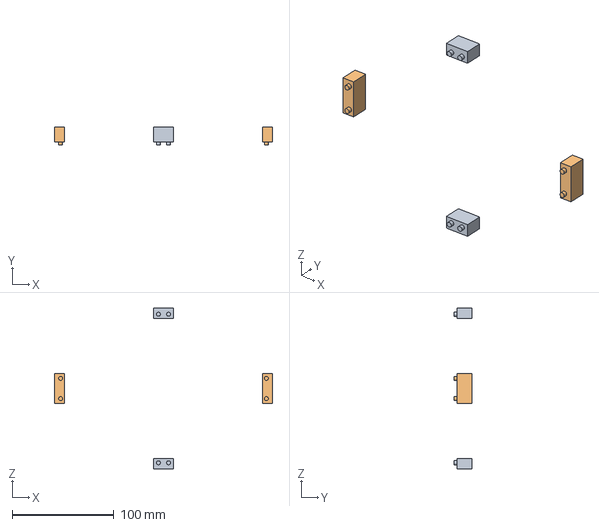
[picture p4: CAD file, 2026-11-13]
STEP/压框顶凸台x4.step
214.7 x 17.5 x 158.3 mm
