pokliu/battery_frame/STEP/电芯座A.step

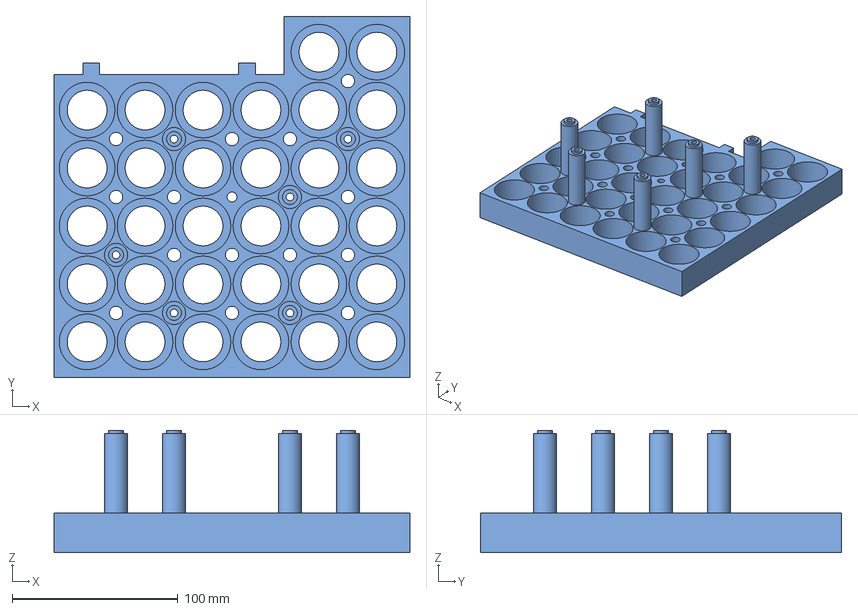
[picture p5: CAD file, 2026-11-13]
STEP/电芯座A.step
214.7 x 218.0 x 73.8 mm
