pokliu/battery_frame/STEP/端盖B.step

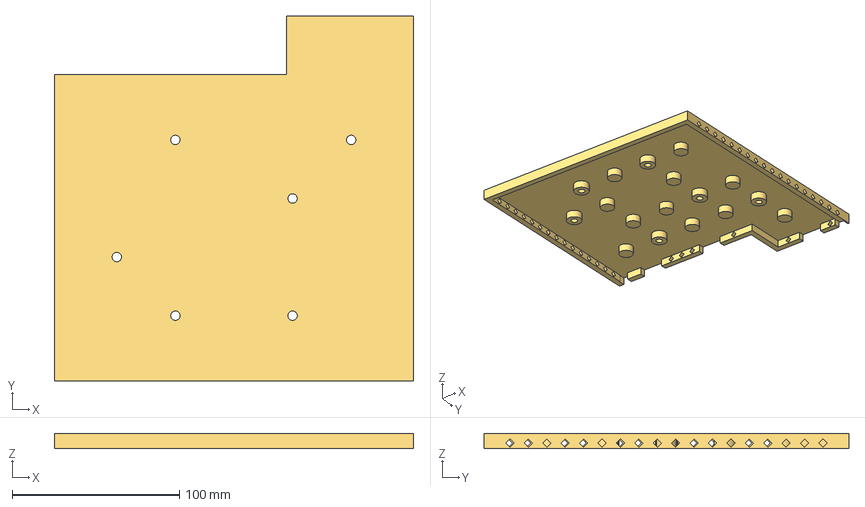
[picture p6: CAD file, 2026-11-13]
STEP/端盖B.step
214.7 x 218.0 x 8.70 mm
