pokliu/battery_frame/STEP/试打块.step

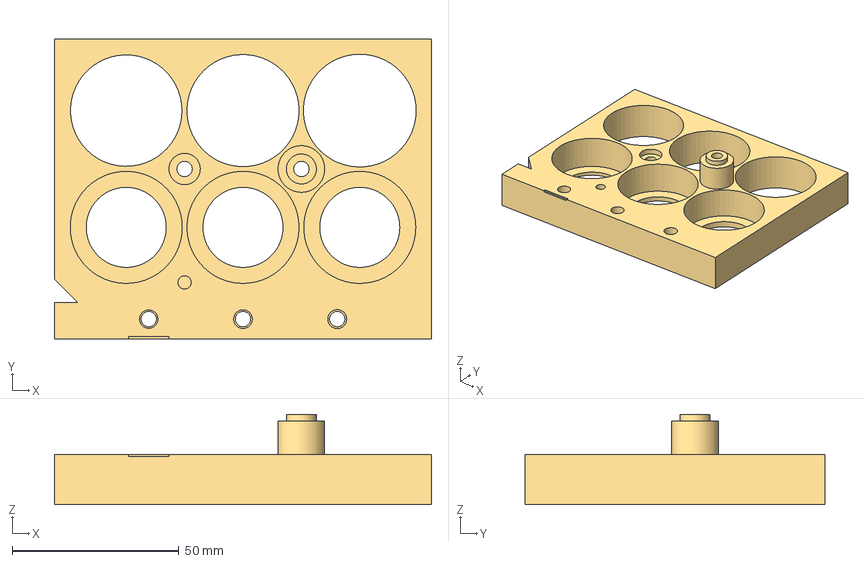
[picture p7: CAD file, 2026-11-13]
STEP/试打块.step
113.0 x 90.0 x 27.0 mm
