pokliu/battery_frame/STEP/顶部压框.step

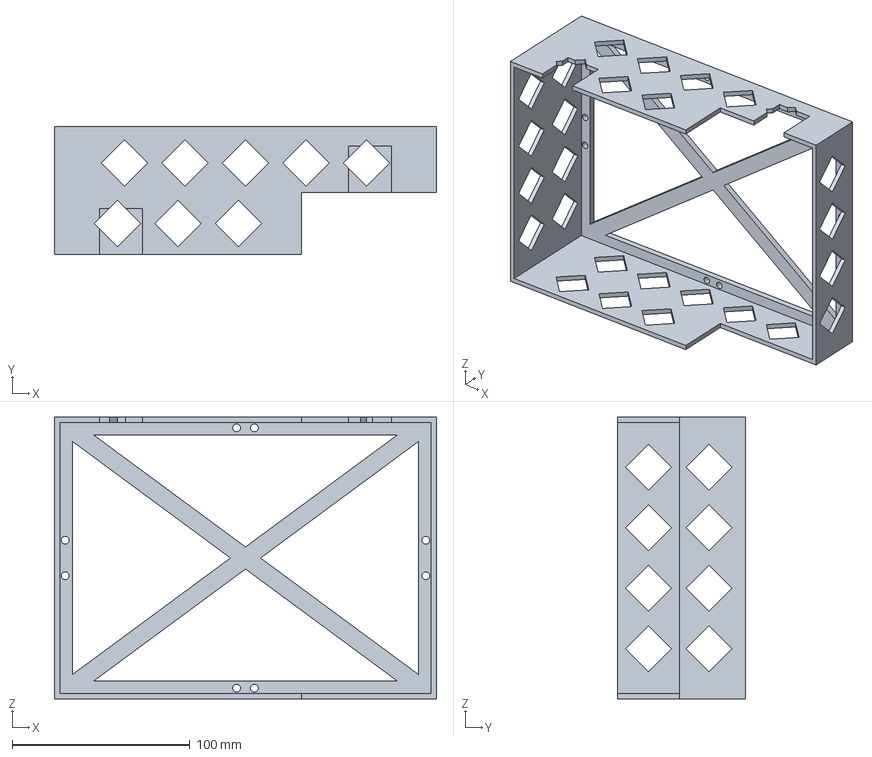
[picture p8: CAD file, 2026-11-13]
STEP/顶部压框.step
214.7 x 72.0 x 158.3 mm
