pokliu/battery_frame/(list of files, cad)

Other CAD files:
STL/压框顶凸台x4.stl
STL/电芯座A.stl
STL/电芯座B.stl
STL/端盖A.stl
STL/端盖B.stl
STL/试打块.stl
STL/顶部压框.stl
