pokliu/battery_frame/(commit log)

2026-11-06 电池支架 v2：参数化建模脚本、模型、STL/STEP 与文档
    [主体.step, 主体.stl, 电池支架_v2.FCStd, 端盖L_A端.step, 端盖L_A端.stl, 端盖R_B端.step, 端盖R_B端.stl, 试打块.step]
2026-11-10 受力分析（5g 冲击 / 50°C）：端盖挡板加厚到 2.5、每端 15 颗螺丝；新增 AGENTS.md 与 FEA 报告
    [主体.step, 主体.stl, 电池支架_v2.FCStd, 端盖L_A端.step, 端盖L_A端.stl, 端盖R_B端.step, 端盖R_B端.stl, 试打块.step]
2026-11-13 quick fix
    [压框顶凸台x4.step, 电池支架_v3.FCStd, 电芯座A.step, 电芯座B.step, 端盖A.step, 端盖A.stl, 端盖B.step, 端盖B.stl]
